breckenedge/parametric-hinge-router-template/(commit log)

2026-10-23 Add parametric hinge mortise router template
    [hinge_router_template.scad]
2026-10-23 Add README with parameters and bit/bearing tables
2026-10-24 Lower router guide surface so the bit reaches cut depth
    Add bit_reach, cut_depth and router_base parameters. Where the router
    base rides, the top face is lowered to bit_reach - cut_depth so the bit
    cuts cut_depth into the door. cut_depth defaults to 3/32", half of a
    3/16" closed hinge.
    [hinge_router_template.scad]
2026-10-24 Return to full-thickness plate; keep cut_depth for bit setup
    Drop the lowered router guide surface and its bit_reach / router_base
    parameters. cut_depth stays and is used to report the bit extension
    (plate_thickness + cut_depth).
    [hinge_router_template.scad]
2026-10-24 Thicken template plate to 3/4" for a 1/2" cutter
    With a 1/2" cutter below the bearing and a 3/32" cut, the bearing starts
    13/32" above the door. A 3/4" plate leaves 11/32" of edge, so a 3/16"
    bearing rides fully with room to lower the bit.
    [hinge_router_template.scad]
